TurtleWhal/ClockClock/CAD/Assembly.SLDASM

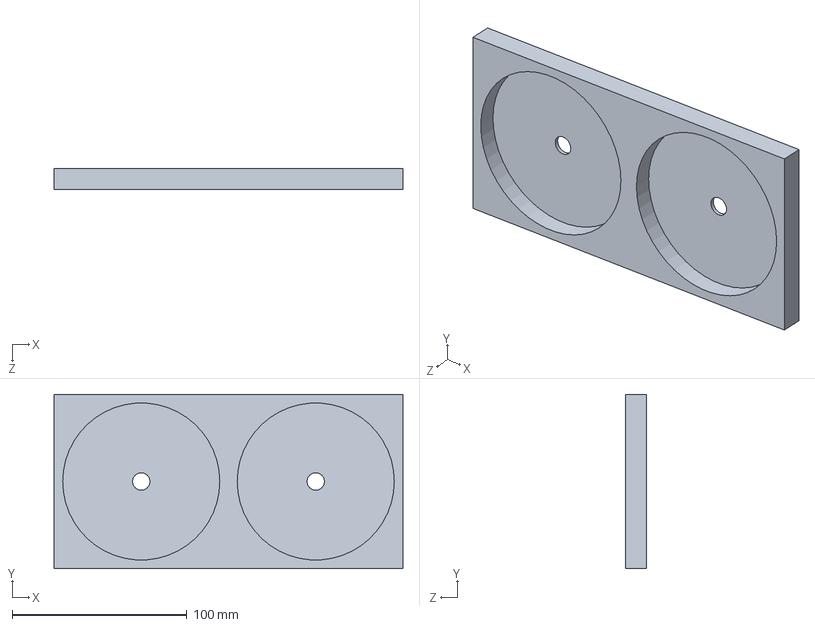
[picture p1: CAD file, 2025-03-16]
CAD/Assembly.SLDASM
200.0 x 100.0 x 12.0 mm
