TurtleWhal/ClockClock/Schematic/ClockProject.step

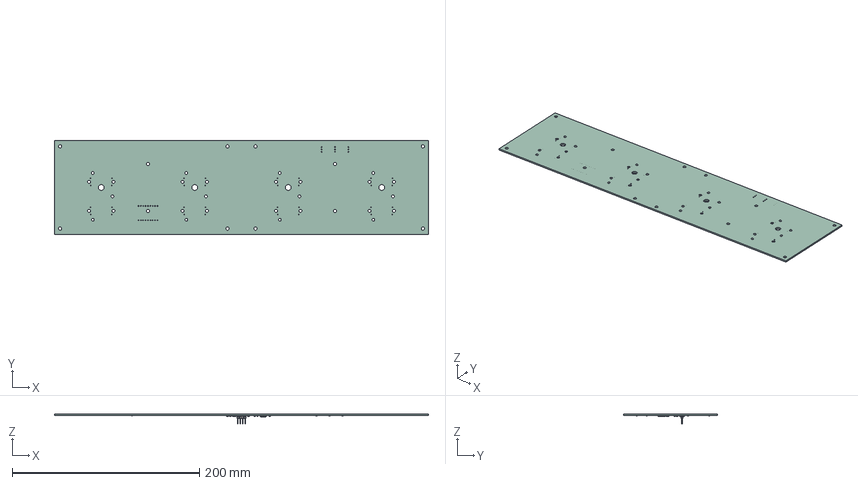
[picture p2: CAD file, 2025-03-02]
Schematic/ClockProject.step
400.0 x 100.0 x 11.0 mm
C_0805_2012Metric x 15
PinHeader_1x04_P254mm_Vertical_SMD_Pin1Right
Crystal_SMD_TXC_7M-4Pin_3.2x2.5mm
R_0805_2012Metric x 9
SOT_223
L_0805_2012Metric
_autosave-ClockProject_PCB
