TurtleWhal/ClockClock/CAD/Top Hand.SLDPRT

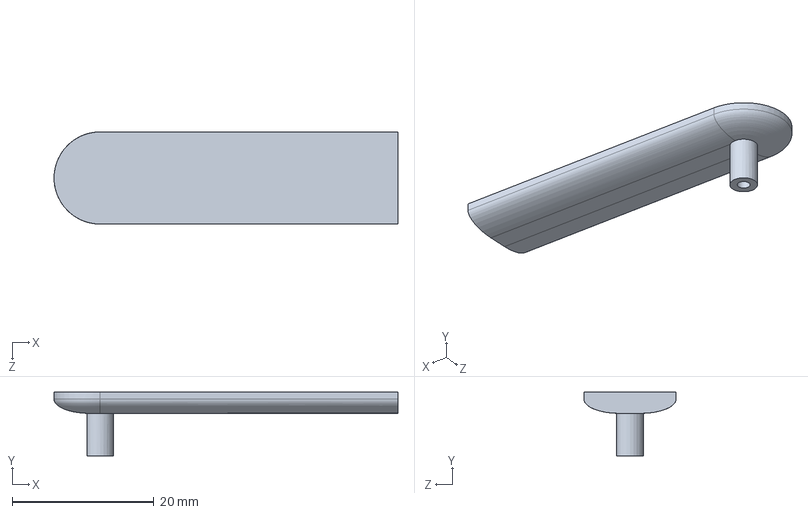
[picture p3: CAD file, 2025-03-16]
CAD/Top Hand.SLDPRT
48.5 x 9.00 x 13.0 mm
