TurtleWhal/ClockClock/CAD/Bottom Hand.SLDPRT

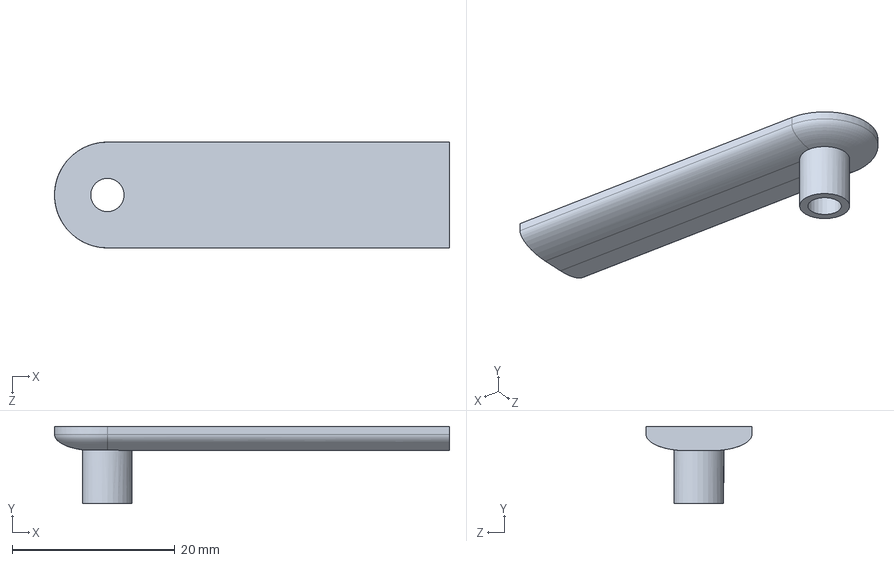
[picture p4: CAD file, 2025-03-02]
CAD/Bottom Hand.SLDPRT
48.5 x 9.50 x 13.0 mm
