TurtleWhal/ClockClock/(list of files, cad)

Other CAD files:
CAD/Cover.SLDPRT
CAD/Bottom Hand.3MF
CAD/Cover.3MF
CAD/Top Hand.3MF
