TurtleWhal/ClockClock/Schematic/ClockProject.kicad_pcb

## KiCad design Schematic/ClockProject.kicad_pcb (2025-02-25)

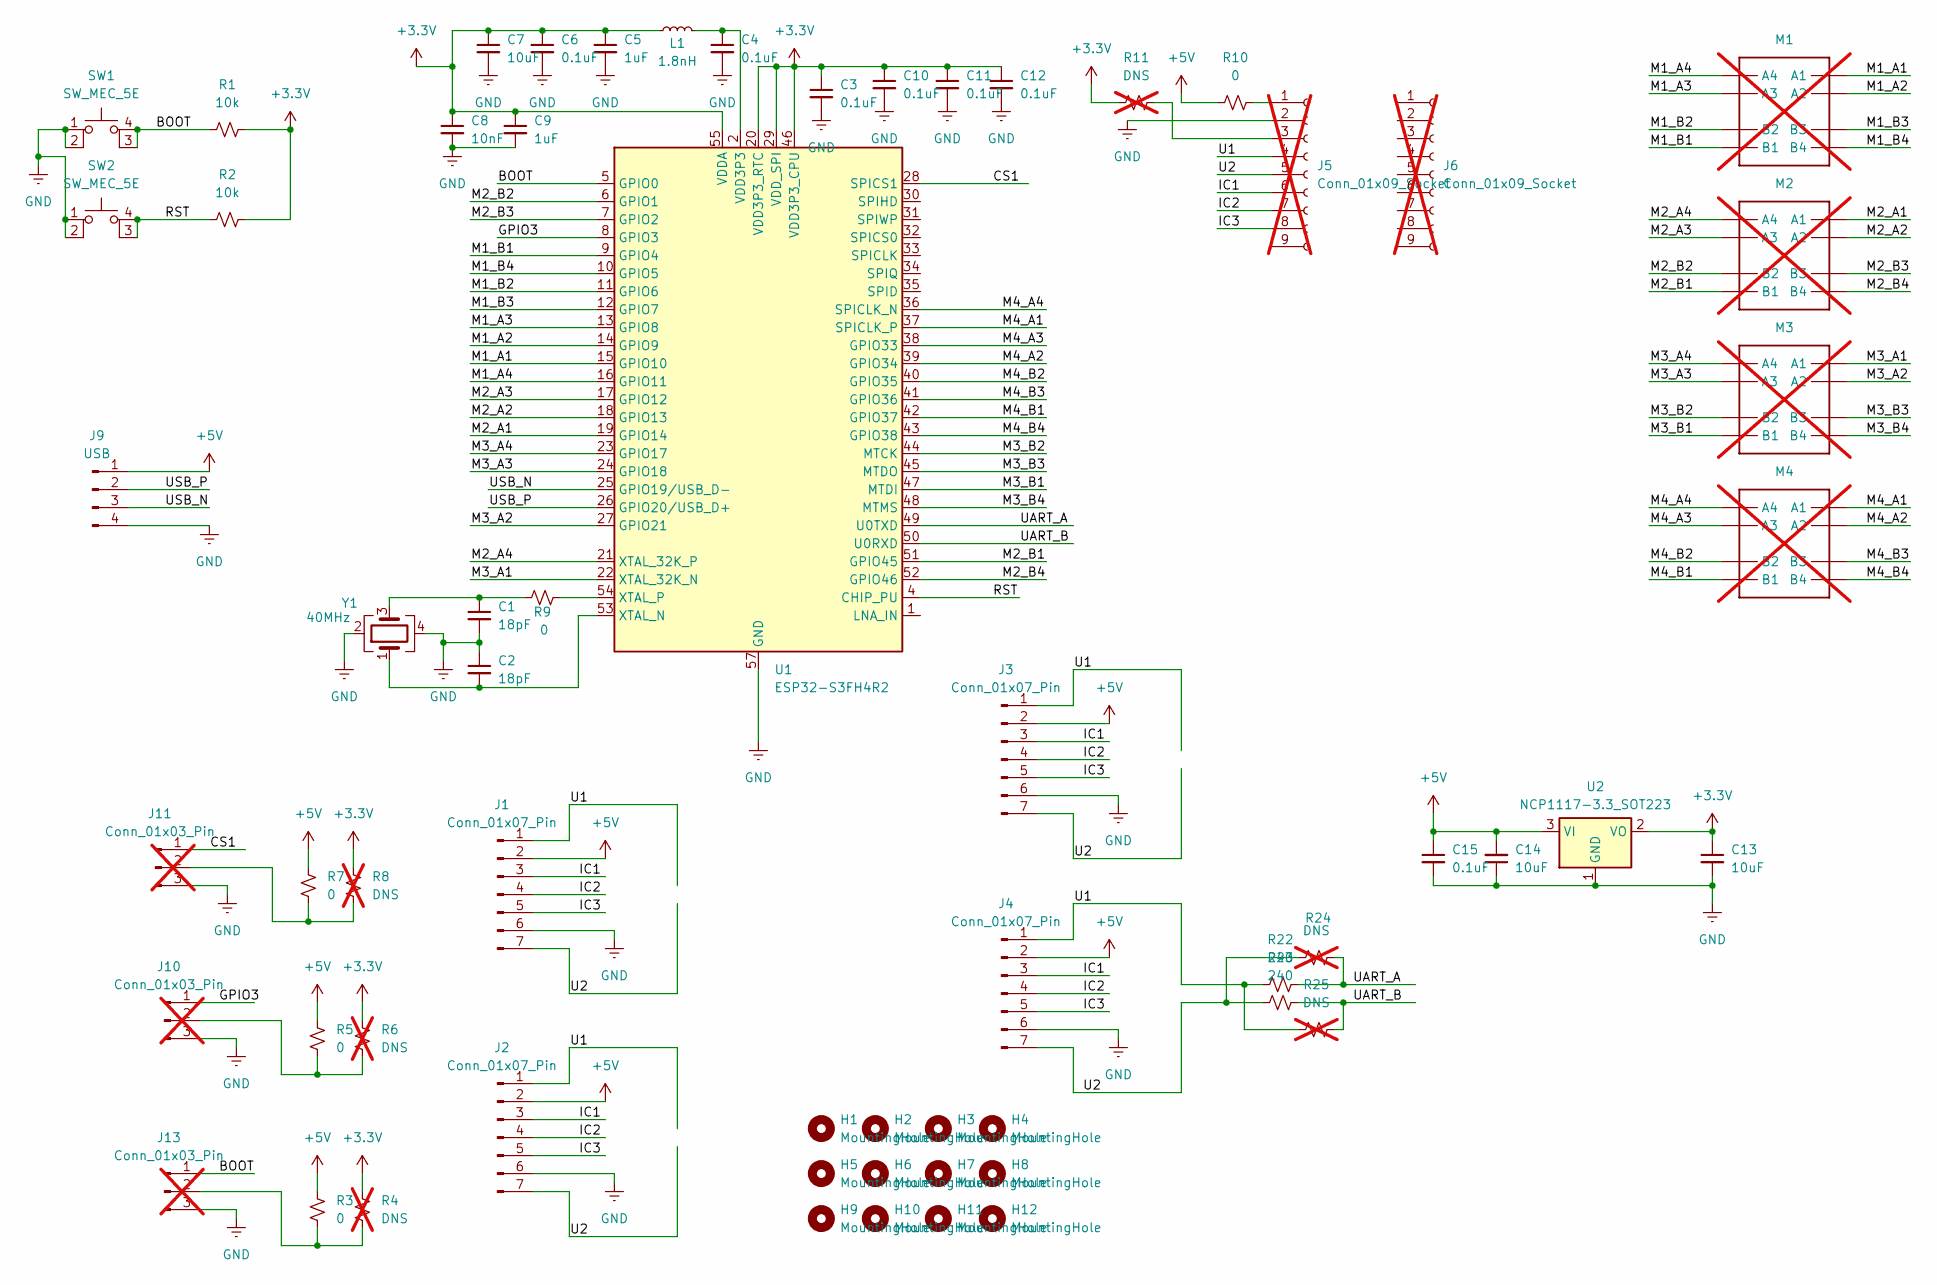
[picture p5: schematic ClockProject.kicad_sch]

Parts:
C1, C2: 18pF; C_0805_2012Metric; LCSC Part # C1797
C3, C4, C6, C10, C11, C12, C15: 0.1uF; C_0805_2012Metric; LCSC Part # C49678
C5, C9: 1uF; C_0805_2012Metric; LCSC Part # C28323
C7, C13, C14: 10uF; C_0805_2012Metric; LCSC Part # C15850
C8: 10nF; C_0805_2012Metric; LCSC Part # C1710
H1, H2, H3, H4, H5, H6, H7, H8, H9, H10, H11, H12: MountingHole; MountingHole_3.5mm
J1, J2: Conn_01x07_Pin; HDR-SMD_7P-P2.54-H-F-L11.5; LCSC Part # C5142240
J3, J4: Conn_01x07_Pin; HDR-SMD_7P-P2.54-H-F-L11.5-RIGHT; LCSC Part # C5142240
J5, J6: Conn_01x09_Socket; PinSocket_1x09_P2.54mm_Vertical; not fitted
J9: USB; PinHeader_1x04_P2.54mm_Vertical_SMD_Pin1Right; LCSC Part # C2984276
J10, J11, J13: Conn_01x03_Pin; PinSocket_1x03_P2.54mm_Vertical; not fitted
L1: 1.8nH; L_0805_2012Metric; LCSC Part # C1036
M1, M2, M3, M4: VID28-05; not fitted
R1, R2: 10k; R_0805_2012Metric; LCSC Part # C17414
R3, R5, R7, R9, R10: 0; R_0805_2012Metric; LCSC Part # C17477
R4, R6, R8, R24, R25: DNS; R_0805_2012Metric; not fitted
R11: DNS; R_0805_2012Metric; LCSC Part # C17572; not fitted
R22, R23: 240; R_0805_2012Metric; LCSC Part # C17572
SW1, SW2: SW_MEC_5E; SW-SMD_4P-L5.1-W5.1-P3.70-LS6.5-TL_H1.5; LCSC Part # C318884
U1: ESP32-S3FH4R2; QFN56_S3FH4R2_EXP; LCSC Part # C3013940
U2: NCP1117-3.3_SOT223; SOT-223-3_TabPin2; LCSC Part # C6186
Y1: 40MHz; Crystal_SMD_TXC_7M-4Pin_3.2x2.5mm; LCSC Part # C19191260

Connections:
+3.3V: C3.1, C5.1, C6.1, C7.1, C8.1, C9.1, C10.1, C11.1, C12.1, C13.1, L1.1, R1.2, R2.2, R4.2, R6.2, R8.2, R11.2, U1.20 (VDD3P3_RTC), U1.29 (VDD_SPI), U1.46 (VDD3P3_CPU), U1.55 (VDDA), U1.56 (VDDA), U2.2 (VO)
+5V: C14.2, C15.1, J1.2, J2.2, J3.2, J4.2, J9.1, R3.2, R5.2, R7.2, R10.2, U2.3 (VI)
/BOOT: J13.1, R1.1, SW1.3 (K), SW1.4 (A), U1.5 (GPIO0)
/CS1: J11.1, U1.28 (SPICS1)
/GPIO3: J10.1, U1.8 (GPIO3)
/IC1: J1.3, J2.3, J3.3, J4.3, J5.6
/IC2: J1.4, J2.4, J3.4, J4.4, J5.7
/IC3: J1.5, J2.5, J3.5, J4.5, J5.8
/M1_A1: M1.A1, U1.15 (GPIO10)
/M1_A2: M1.A2, U1.14 (GPIO9)
/M1_A3: M1.A3, U1.13 (GPIO8)
/M1_A4: M1.A4, U1.16 (GPIO11)
/M1_B1: M1.B1, U1.9 (GPIO4)
/M1_B2: M1.B2, U1.11 (GPIO6)
/M1_B3: M1.B3, U1.12 (GPIO7)
/M1_B4: M1.B4, U1.10 (GPIO5)
/M2_A1: M2.A1, U1.19 (GPIO14)
/M2_A2: M2.A2, U1.18 (GPIO13)
/M2_A3: M2.A3, U1.17 (GPIO12)
/M2_A4: M2.A4, U1.21 (XTAL_32K_P)
/M2_B1: M2.B1, U1.51 (GPIO45)
/M2_B2: M2.B2, U1.6 (GPIO1)
/M2_B3: M2.B3, U1.7 (GPIO2)
/M2_B4: M2.B4, U1.52 (GPIO46)
/M3_A1: M3.A1, U1.22 (XTAL_32K_N)
/M3_A2: M3.A2, U1.27 (GPIO21)
/M3_A3: M3.A3, U1.24 (GPIO18)
/M3_A4: M3.A4, U1.23 (GPIO17)
/M3_B1: M3.B1, U1.47 (MTDI)
/M3_B2: M3.B2, U1.44 (MTCK)
/M3_B3: M3.B3, U1.45 (MTDO)
/M3_B4: M3.B4, U1.48 (MTMS)
/M4_A1: M4.A1, U1.37 (SPICLK_P)
/M4_A2: M4.A2, U1.39 (GPIO34)
/M4_A3: M4.A3, U1.38 (GPIO33)
/M4_A4: M4.A4, U1.36 (SPICLK_N)
/M4_B1: M4.B1, U1.42 (GPIO37)
/M4_B2: M4.B2, U1.40 (GPIO35)
/M4_B3: M4.B3, U1.41 (GPIO36)
/M4_B4: M4.B4, U1.43 (GPIO38)
/RST: R2.1, SW2.3 (K), SW2.4 (A), U1.4 (CHIP_PU)
/U1: J1.1, J2.1, J3.1, J4.1, J5.4, R22.2, R25.2
/U2: J1.7, J2.7, J3.7, J4.7, J5.5, R23.2, R24.2
/UART_A: R22.1, R24.1, U1.49 (U0TXD)
/UART_B: R23.1, R25.1, U1.50 (U0RXD)
/USB_N: J9.3, U1.25 (GPIO19/USB_D-)
/USB_P: J9.2, U1.26 (GPIO20/USB_D+)
GND: C1.2, C2.1, C3.2, C4.2, C5.2, C6.2, C7.2, C8.2, C9.2, C10.2, C11.2, C12.2, C13.2, C14.1, C15.2, J1.6, J2.6, J3.6, J4.6, J5.2, J9.4, J10.3, J11.3, J13.3, SW1.1, SW1.2, SW2.1, SW2.2, U1.57 (GND), U2.1 (GND), Y1.2, Y1.4
unnamed: C1.1, R9.2, Y1.3
unnamed: C4.1, L1.2, U1.2 (VDD3P3), U1.3 (VDD3P3)
unnamed: J5.1, R10.1
unnamed: J5.3, R11.1
unnamed: J10.2, R5.1, R6.1
unnamed: J11.2, R7.1, R8.1
unnamed: J13.2, R3.1, R4.1
unnamed: C2.2, U1.53 (XTAL_N), Y1.1
unnamed: R9.1, U1.54 (XTAL_P)

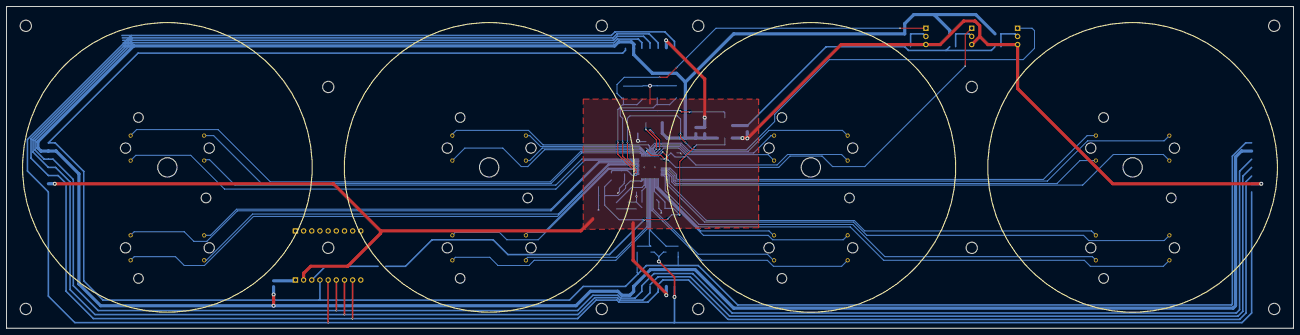
[picture p6: board ClockProject.kicad_pcb from above]

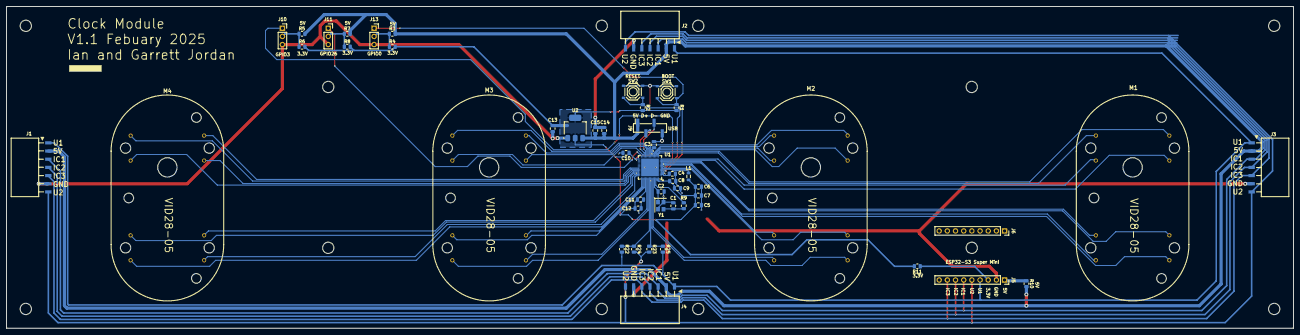
[picture p7: board ClockProject.kicad_pcb from below]

Board: 2 copper layers, 400.0 x 100.0 mm, 62 parts (50 on the bottom side), 57 nets.
