TurtleWhal/ClockClock/Code/Module/src/main.cpp

#include "Arduino.h"
#include "ClockModule.h"
#include "SerialTransfer.h"
#include "Update.h"
#include "esp_task_wdt.h"
#include "version.h"

#include "../../Master/src/motorcontrol.h"
#include <rom/gpio.h>

#include "mcpwm.h"
#include "pwm.h"

// #include "NewStepper.h"
#include "MotorController.h"

#define BAUDRATE 2000000
#define BUFFER_SIZE (1024 * 1024) // 1MB buffer for FW updates

uint8_t *largeBuffer; // For Firmware Updates, located in PSRAM

SerialTransfer serialTransfer;

int in = 0, out = 0;

// ClockModule *modules[4];

NewStepper *motor1F =
    new NewStepper(M1_A1, M1_A2, M1_A3, M1_A4, MICRO_STEP_MCPWM);
NewStepper *motor1B =
    new NewStepper(M1_B3, M1_B4, M1_B1, M1_B2, MICRO_STEP_LEDC);
NewStepper *motor2F =
    new NewStepper(M2_A1, M2_A2, M2_A3, M2_A4, MICRO_STEP_MCPWM);
NewStepper *motor2B =
    new NewStepper(M2_B3, M2_B4, M2_B1, M2_B2, MICRO_STEP_LEDC);
NewStepper *motor3F =
    new NewStepper(M3_A1, M3_A2, M3_A3, M3_A4, MICRO_STEP_MCPWM);
NewStepper *motor3B =
    new NewStepper(M3_B3, M3_B4, M3_B1, M3_B2, MICRO_STEP_LEDC);
NewStepper *motor4F =
    new NewStepper(M4_A1, M4_A2, M4_A3, M4_A4, MICRO_STEP_MCPWM);
NewStepper *motor4B =
    new NewStepper(M4_B3, M4_B4, M4_B1, M4_B2, MICRO_STEP_LEDC);

MotorController *motor1FControl = new MotorController(motor1F);
MotorController *motor1BControl = new MotorController(motor1B);
MotorController *motor2FControl = new MotorController(motor2F);
MotorController *motor2BControl = new MotorController(motor2B);
MotorController *motor3FControl = new MotorController(motor3F);
MotorController *motor3BControl = new MotorController(motor3B);
MotorController *motor4FControl = new MotorController(motor4F);
MotorController *motor4BControl = new MotorController(motor4B);

MotorController *motors[4][2] = {{motor1BControl, motor1FControl},
                                 {motor2BControl, motor2FControl},
                                 {motor3BControl, motor3FControl},
                                 {motor4BControl, motor4FControl}};

void serialTask(void *);

void setup() {
  setCpuFrequencyMhz(240); // Set CPU frequency to 240 MHz

  // Serial
  Serial.begin(1000000);
  Serial.print("Helooo. I am a Module. I am V");
  Serial.print(VERSION_BUILD);
  Serial.print(". I was built on ");
  Serial.print(VERSION_DATE);
  Serial.print(" at ");
  Serial.println(VERSION_TIME);

  // The fast stepping loop (core 1) and the serial loop (core 0) both run
  // without yielding, each starving its core's idle task. The Task WDT monitors
  // core 0's idle by default, which would panic ~5 s after the serial task
  // starts. Stop the WDT from watching any idle task (idle_core_mask = 0). This
  // is consistent with the firmware's design of dedicating cores to
  // non-yielding loops; INT_WDT and the esp_timer velocity tick are unaffected.
  esp_task_wdt_config_t wdtConfig = {
      .timeout_ms = 5000,
      .idle_core_mask = 0, // do not monitor either core's idle task
      .trigger_panic = true,
  };
  esp_task_wdt_reconfigure(&wdtConfig);

  log_d("Total heap: %d", ESP.getHeapSize());
  log_d("Free heap: %d", ESP.getFreeHeap());
  log_d("Total PSRAM: %d", ESP.getPsramSize());
  log_d("Used PSRAM: %d", ESP.getPsramSize() - ESP.getFreePsram());
  log_d("Free PSRAM: %d", ESP.getFreePsram());
  log_d("Creating Buffer!");

  largeBuffer = (byte *)ps_malloc(BUFFER_SIZE); // For FW updates

  log_d("Used PSRAM: %d", ESP.getPsramSize() - ESP.getFreePsram());
  log_d("Free PSRAM: %d", ESP.getFreePsram());

#ifndef MOTOR_TEST

  pinMode(UART_A, INPUT_PULLDOWN);
  pinMode(UART_B, INPUT_PULLDOWN);

  Serial1.setPins(UART_A, -1); // No output pin, only RX
  Serial2.setPins(UART_B, -1);
  Serial1.begin(BAUDRATE);
  Serial2.begin(BAUDRATE);

  Serial1.flush();
  Serial2.flush();

  Serial.print("Listening for input pins ");

  bool listening = true;

  while (listening) // wait until previous module sends message to determine
                    // input and output pins
  {
    if (Serial1.available() > 10) {
      in = UART_A;
      out = UART_B;
      listening = false;
      Serial.println("");
      Serial.println("Using UART_A as input");
    } else if (Serial2.available() > 10) {
      in = UART_B;
      out = UART_A;
      listening = false;
      Serial.println("");
      Serial.println("Using UART_B as input");
    } else {
      Serial.print(".");
      delay(100);
    }
  }

  Serial1.end();
  Serial2.end();

  pinMode(in, INPUT);
  pinMode(out, OUTPUT);

  Serial1.setPins(in, out);
  Serial1.setRxBufferSize(1024);
  Serial1.begin(BAUDRATE);
  Serial1.setRxFIFOFull(121u);

  serialTransfer.begin(Serial1);

  // Send init message to next module downstream
  uint16_t sendSize = 0;
  sendSize = serialTransfer.txObj((uint8_t)200, sendSize);
  sendSize = serialTransfer.txObj("Hello10Bytes", sendSize);
  serialTransfer.sendData(sendSize);

  // initPWM();

  // Only the two magnitude legs per motor (pin1A/pin2A) go to MCPWM. The
  // direction legs (pin1B/pin2B) MUST stay plain GPIO so digitalWrite in
  // writeMicrostep can flip coil polarity; bind them to MCPWM and they're stuck
  // at idle duty, the field never reverses, and the motor only vibrates.
  // Called after the constructors so MCPWM owns the pad last.
  mcpwmInit((uint8_t[]){M1_A1, M1_A3, M2_A1, M2_A3, M3_A1, M3_A3, M4_A1, M4_A3},
            8);

  // LEDC "B" motors: attach each magnitude coil (pin1A/pin2A of the B steppers)
  // to a known channel so the stepping loop can drop duties in with no lookup or
  // lock — the LEDC analogue of mcpwmInit above.
  ledcFastInit((uint8_t[]){M1_B3, M1_B1, M2_B3, M2_B1, M3_B3, M3_B1, M4_B3,
                           M4_B1},
               8);

  for (uint8_t i = 0; i < 4; i++) {
    motors[i][0]->setPosition(90);
    motors[i][1]->setPosition(90);

    MotorControl_t bInit;
    bInit.position = i % 2 == 0 ? 135 : 45;
    bInit.time = 3000;
    bInit.direction = MotorDirection_t::MOTOR_CW;
    MotorControl_t fInit;
    fInit.position = i % 2 == 0 ? 315 : 225;
    fInit.time = 3000;
    fInit.direction = MotorDirection_t::MOTOR_CW;

    motors[i][0]->applyControl(bInit);
    motors[i][1]->applyControl(fInit);
  }

  // modules[0] = new ClockModule(0);
  // modules[1] = new ClockModule(1);
  // modules[2] = new ClockModule(2);
  // modules[3] = new ClockModule(3);

  // Launch the motion loops: the fast stepping busy loop on core 1 and the
  // 1 kHz velocity esp_timer (core 0). Without this NOTHING moves — applyControl
  // only sets the target; these loops are what actually step the motors.
  MotorController::startLoops();

  // Run the serial loop on core 0, leaving core 1 to the fast stepping loop.
  // Stack matches the Arduino loop task (the firmware-update path needs the
  // headroom).
  xTaskCreatePinnedToCore(serialTask, "SerialTask", 8192, NULL, 1, NULL, 0);

  // MotorControl_t init;
  // init.direction = MotorDirection_t::MOTOR_CW;
  // init.speed = 45;
  // init.keepRunning = true;

  // motor4BControl->applyControl(init);

#else

  NewStepper *motor1F =
      new NewStepper(M1_A1, M1_A2, M1_A3, M1_A4, MICRO_STEP_MCPWM);
  NewStepper *motor1B =
      new NewStepper(M1_B3, M1_B4, M1_B1, M1_B2, MICRO_STEP_LEDC);
  NewStepper *motor2F =
      new NewStepper(M2_A1, M2_A2, M2_A3, M2_A4, MICRO_STEP_MCPWM);
  NewStepper *motor2B =
      new NewStepper(M2_B3, M2_B4, M2_B1, M2_B2, MICRO_STEP_LEDC);
  NewStepper *motor3F =
      new NewStepper(M3_A1, M3_A2, M3_A3, M3_A4, MICRO_STEP_MCPWM);
  NewStepper *motor3B =
      new NewStepper(M3_B3, M3_B4, M3_B1, M3_B2, MICRO_STEP_LEDC);
  NewStepper *motor4F =
      new NewStepper(M4_A1, M4_A2, M4_A3, M4_A4, MICRO_STEP_MCPWM);
  NewStepper *motor4B =
      new NewStepper(M4_B3, M4_B4, M4_B1, M4_B2, MICRO_STEP_LEDC);

  // Only the two magnitude legs per motor (pin1A/pin2A) go to MCPWM. The
  // direction legs (pin1B/pin2B) MUST stay plain GPIO so digitalWrite in
  // writeMicrostep can flip coil polarity; bind them to MCPWM and they're stuck
  // at idle duty, the field never reverses, and the motor only vibrates.
  // Called after the constructors so MCPWM owns the pad last.
  mcpwmInit((uint8_t[]){M1_A1, M1_A3, M2_A1, M2_A3, M3_A1, M3_A3, M4_A1, M4_A3},
            8);

  MotorController *motor1FControl = new MotorController(motor1F);
  MotorController *motor1BControl = new MotorController(motor1B);
  MotorController *motor2FControl = new MotorController(motor2F);
  MotorController *motor2BControl = new MotorController(motor2B);
  MotorController *motor3FControl = new MotorController(motor3F);
  MotorController *motor3BControl = new MotorController(motor3B);
  MotorController *motor4FControl = new MotorController(motor4F);
  MotorController *motor4BControl = new MotorController(motor4B);

  MotorControl_t c;

  // c.direction = MotorDirection_t::MOTOR_CW;

  // motor4FControl->applyControl(c);

  // while (true) {
  //   c.direction = MotorDirection_t::MOTOR_CW;
  //   c.speed = 90;
  //   c.keepRunning = true;
  //   motor4FControl->applyControl(c);

  //   delay(11000);

  //   c.position = 0;
  //   c.direction = MotorDirection_t::MOTOR_CCW;
  //   c.time = 5000;
  //   c.keepRunning = false;
  //   motor4FControl->applyControl(c);

  //   delay(7000);
  // }

  // MotorControl_t init;
  //   init.direction = MotorDirection_t::MOTOR_CW;
  //   init.speed = 45;
  //   init.keepRunning = true;

  //   motor4BControl->applyControl(init);

  while (true) {
    motor4F->step();
    delayMicroseconds(1000000 / (45 * MICRO_STEPS_PER_DEGREE));
  }

    // Launch the motion loops: the fast stepping busy loop on core 1 and the
    // 1 kHz velocity esp_timer (core 0). Motors don't move until this runs.
    // MotorController::startLoops();
#endif
}

bool firmwareUpdate = false;
uint32_t firmwareSize = 0;
uint32_t recievedBytes = 0;

// All serial RX/parse/forward and the firmware-update cascade. Runs in its own
// task on core 0 (see setup) so it stays off core 1, which the fast stepping
// loop owns. The 1 kHz velocity esp_timer also lives on core 0 and just briefly
// preempts this at higher priority — that's fine; serial RX is FIFO/ring-buffered.
void serialLoopBody() {
  if (firmwareUpdate) {
    if (serialTransfer.available()) {
      uint16_t recSize = 0;
      uint32_t byte;
      recSize = serialTransfer.rxObj(byte, recSize);

      // Firmware Update packet handler
      if (serialTransfer.currentPacketID() == 1) {
        for (uint8_t i = 4; i < serialTransfer.bytesRead; i++) {
          largeBuffer[recievedBytes] = serialTransfer.packet.rxBuff[i];
          recievedBytes++;
        }
      } else if (serialTransfer.currentPacketID() == 2) {
        firmwareUpdate = false;
        Serial.println("Firmware update file recieved, size: " +
                       String(recievedBytes) + " bytes");

        Serial.println("Executing Update");
        if (!Update.begin(recievedBytes)) {
          Serial.println("Out of Space!");
          return;
        } else
          Serial.println("Plenty of Space!");

        Update.write(largeBuffer, recievedBytes);

        if (Update.end()) {
          Serial.println("Successful update, rebooting...");
          Serial.flush();
          ESP.restart();
        } else {
          Serial.println("Error Occurred: " + String(Update.getError()));
          Serial.println("Update aborted!");
          return;
        }
      }
    }
    return;
  }

  if (serialTransfer.available()) {
    uint16_t recSize = 0;
    uint8_t address;
    recSize = serialTransfer.rxObj(address, recSize);

    if (address < 200) {
      MotorControl_t buffer[4][2];
      recSize = serialTransfer.rxObj(buffer, recSize);

      if (address > 0) {
        // forward packets to next module

        uint16_t sendSize = 0;
        uint8_t sendAddress = address - 1;
        sendSize = serialTransfer.txObj(sendAddress, sendSize);
        sendSize = serialTransfer.txObj(buffer, sendSize);

        Serial.printf("Recieved for %d, forwarding to %d\n", address,
                      sendAddress);

        serialTransfer.sendData(sendSize);
      } else {
        // address 0 mean it is for me
        Serial.print("Buffer: [");
        for (int i = 0; i < 4; i++) {
          Serial.print("[" + String(buffer[i][0].position) + ", " +
                       String(buffer[i][1].position) + "]" +
                       (i < 3 ? ", " : ""));
        }
        Serial.println("]");

        for (int i = 0; i < 4; i++) {
          if (buffer[i][0].optimize && buffer[i][1].optimize) {
            // uint16_t distA =
            //     abs(modules[i]->hourStepper->getCurrentPosition() -
            //         buffer[i][0].position) +
            //     abs(modules[i]->minuteStepper->getCurrentPosition() -
            //         buffer[i][1].position);
            // uint16_t distB =
            //     abs(modules[i]->minuteStepper->getCurrentPosition() -
            //         buffer[i][0].position) +
            //     abs(modules[i]->hourStepper->getCurrentPosition() -
            //         buffer[i][1].position);
            uint16_t distA =
                abs(motors[i][0]->getCurrentPosition() -
                    buffer[i][0].position) +
                abs(motors[i][1]->getCurrentPosition() - buffer[i][1].position);
            uint16_t distB =
                abs(motors[i][0]->getCurrentPosition() -
                    buffer[i][0].position) +
                abs(motors[i][1]->getCurrentPosition() - buffer[i][1].position);

            if (distB < distA) {
              // swap positions
              MotorControl_t temp = buffer[i][0];
              buffer[i][0] = buffer[i][1];
              buffer[i][1] = temp;
            }
          }

          // modules[i]->hourStepper->applyMotorControl(buffer[i][0]);
          // modules[i]->minuteStepper->applyMotorControl(buffer[i][1]);

          motors[i][0]->applyControl(buffer[i][0]);
          motors[i][1]->applyControl(buffer[i][1]);
        }
      }
    } else {
      switch (address) {
      case 200:
        // sent from previous module to determine input and output pins
        break;
      case 201: {
        // start recieving new firmware
        firmwareUpdate = true;
        recievedBytes = 0;
        serialTransfer.rxObj(firmwareSize, recSize);
        Serial.println("A FW Update Starting, expected size: " +
                       String(firmwareSize) + " bytes");

        uint16_t headerSize = 0;

        uint8_t address = 201;
        headerSize = serialTransfer.txObj(address, headerSize);
        headerSize = serialTransfer.txObj(firmwareSize, headerSize);

        serialTransfer.sendData(headerSize);

        Serial1.flush();

        Serial1.end();
        Serial1.setPins(in, -1);
        Serial1.begin(BAUDRATE);

        // mirror the uart input to the output so that all data will be
        // forwarded to the next module to firmware update all of them at the
        // same time me and dad spend a whole weekend figuring out these two
        // lines of code
        gpio_matrix_in(in, SIG_IN_FUNC_212_IDX, false);
        gpio_matrix_out(out, SIG_IN_FUNC_212_IDX, false, false);
        break;
      }
      case 220:
        // Calibration command, zeros motors to straight down (90°)
        for (int i = 0; i < 4; i++) {
          // modules[i]->hourStepper->setPosition(90);
          // modules[i]->minuteStepper->setPosition(90);
          motors[i][0]->setPosition(90);
          motors[i][1]->setPosition(90);
        }
        break;
      }
    }
  }
}

void serialTask(void *) {
  for (;;)
    serialLoopBody();
}

// The Arduino loopTask runs on core 1, which the fast stepping loop owns. Keep
// it dormant so it never steals cycles from stepping; all real work runs in the
// fast loop (core 1), serialTask (core 0), and the velocity esp_timer (core 0).
void loop() { vTaskDelay(portMAX_DELAY); }
