TurtleWhal/ClockClock/Code/Module/src/ClockModule.cpp

#include "ClockModule.h"

ClockModule::ClockModule(int motor)
{
    auto m = motors[motor];

    // hourStepper = new StepperMotor(m[0][0], m[0][1], m[0][2], m[0][3], motor == 0 ? true : false);
    hourStepper = new StepperMotor(m[0][0], m[0][1], m[0][2], m[0][3], false);
    minuteStepper = new StepperMotor(m[1][2], m[1][3], m[1][0], m[1][1]);

    hourStepper->setPosition(90);
    minuteStepper->setPosition(90);

    MotorControl_t hourInit;
    hourInit.position = motor % 2 == 0 ? 135 : 45;
    hourInit.time = 3000;
    hourInit.direction = MotorDirection_t::MOTOR_CW;
    MotorControl_t minuteInit;
    minuteInit.position = motor % 2 == 0 ? 315 : 225;
    minuteInit.time = 3000;
    minuteInit.direction = MotorDirection_t::MOTOR_CW;

    hourStepper->applyMotorControl(hourInit);
    minuteStepper->applyMotorControl(minuteInit);
}
