TurtleWhal/ClockClock/Code/Master/src/version.h

#define VERSION "0.0.0+672"
#define VERSION_MAJOR 0
#define VERSION_MINOR 0
#define VERSION_PATCH 0
#define VERSION_BUILD 672
#define VERSION_DATE "2026-08-24"
#define VERSION_TIME "23:38"
#define VERSION_FULL "0.0.0+672 2026-08-24 23:38"
