TurtleWhal/ClockClock/Code/Module/src/version.h

#define VERSION "0.0.0+1227"
#define VERSION_MAJOR 0
#define VERSION_MINOR 0
#define VERSION_PATCH 0
#define VERSION_BUILD 1227
#define VERSION_DATE "2026-08-17"
#define VERSION_TIME "22:39"
#define VERSION_FULL "0.0.0+1227 2026-08-17 22:39"
