TurtleWhal/ClockClock/(commit log)

2025-02-24 Added schematic and pins.h
    [ClockProject-B_Cu.gbr, ClockProject-B_Mask.gbr, ClockProject-B_Paste.gbr, ClockProject-B_Silkscreen.gbr, ClockProject-Edge_Cuts.gbr, ClockProject-F_Cu.gbr, ClockProject-F_Mask.gbr, ClockProject-F_Paste.gbr]
2025-02-25 Fixed multiple initial issues
    Fixed Silk for Connectors (GND move)
    Fixed Boot/Reset Silk
    Moved Edge Connectors closer to edge
    [ClockProject.kicad_pcb]
2025-02-27 working with timers
2025-03-02 hand cad and microstepping actrually working
    [Assembly.SLDASM, Bottom Hand.3MF, Bottom Hand.SLDPRT, ClockProject.step, Cover.3MF, Cover.SLDPRT, Top Hand.3MF, Top Hand.SLDPRT]
2025-03-02 some stuff
    [Bottom Hand.3MF, Bottom Hand.SLDPRT, Top Hand.3MF, Top Hand.SLDPRT]
2025-03-16 arduino 3.0.0 and serial basically working
    [Assembly.SLDASM, Cover.SLDPRT, Top Hand.3MF, Top Hand.SLDPRT]
2025-04-06 fixed crashing after some time (memory leak)
    [main.cpp]
2025-04-08 PSRAM buffer working, storage working, OTA not working
    [main.cpp]
2025-04-13 steppers working way better
2025-06-02 stepper code ish
2025-06-18 motor control working with acceleration and time
2025-06-18 converted motor control api to degrees
2025-06-19 motor directions working
2025-06-22 Working Software PWM on 16 channels
    dirty code
2025-06-22 Microstepping working with Motor Control code
2025-11-24 Full Clock Working
    [partitions.csv]
2025-11-29 PSRAM firmware updating and cycle mode
    [partitions.csv]
2026-06-14 QOL Changes
    [partitions.csv]
2026-06-22 Better PWM + Animation Timing
2026-07-10 Motor control working well with different analog methods
    Added esp32 mcpwm support to use the 8 analogWrite LEDC channels and 8 mcpwm timers for better microstepping
2026-07-11 Basically complete motor controller
